apeng2012/apeng-kicad/(commit log)

2016-05-12 led 0603 0805
2016-05-12 fix switch SPST
2016-07-29 add stm32f205
2016-10-12 add diode sod 323
2016-10-14 add pin header 1xn footprint
2016-10-14 add Gas Dischanrge Tube and Common mode choke coil
2016-10-15 readme add mklink example; add PinHeader footprints
2016-10-15 fp-lib-table add Pin Header
2016-10-31 add 3.5mm audio jack
2016-10-31 add fuse and SPST_VR
2016-11-01 move SPST_VR from device to switch lib
2016-11-01 add DIP 4 switch
2016-11-02 move sod-323 from SO to Diodes
2016-11-02 add footprint SOD-523
2016-11-02 pin header
2016-11-02 add pin header
2016-11-23 add mpcie.thank mithro kicad-mini-pci-express
2016-11-25 add led 2835
2016-11-28 add stm32f429
2016-11-28 add 2x pin header lib
2016-12-07 add KFT-5.8 DPDT switch
2016-12-07 add led 3mm footprint
2016-12-09 fix mpcie-socket
2016-12-14 add smt wire header footprints
2016-12-23 modify switch MSK_12C01_07
2016-12-27 add button 12x12
2016-12-27 add switch bodong
2016-12-27 add pin
2017-01-13 add ph20 pin6 footprint
2017-02-13 add template normal win
    [normal_win.kicad_pcb, normal_win.sch]
2017-02-14 add template normal ubuntu
    [normal_ubuntu.kicad_pcb, normal_ubuntu.sch]
2017-02-17 add DIP3 switch
2017-02-18 add fuse 1206
2017-05-15 add STM32F-100pin
2017-05-18 modify DB9 add shell pin
2017-05-18 add diode LL34 BAT54C
2017-05-19 add fixed hole
2017-06-23 fix qfp64 first pin
2017-08-16 修改stm32_100pin错误。增加SOT223封装。
2017-08-22 add STM32F042
2017-09-27 多脚元件0度时1脚在左下
2017-10-31 add footprint probe
2017-11-09 fix MP23AB01DH footprint
2017-11-09 fix MARK point footprint
2019-12-10 add 60-pin Famicom consoles and cartridges
